safloresmo/escaner-lidar/docs/img/sensor-montado.jpg

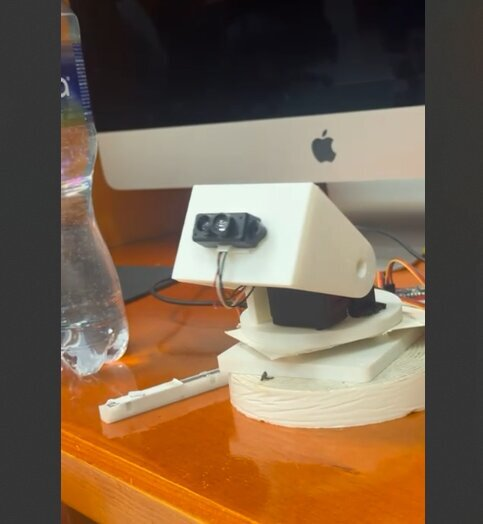
docs/img/sensor-montado.jpg
