safloresmo/escaner-lidar/fpga/restricciones/pynq-z1.xdc

# Copyright (C) 2022 Xilinx, Inc
# SPDX-License-Identifier: BSD-3-Clause

## Switches
set_property -dict {PACKAGE_PIN M20 IOSTANDARD LVCMOS33} [get_ports {sw[0]}]
set_property -dict {PACKAGE_PIN M19 IOSTANDARD LVCMOS33} [get_ports {led[1]}]

## Buttons
set_property -dict {PACKAGE_PIN D19 IOSTANDARD LVCMOS33} [get_ports {btn[0]}]
set_property -dict {PACKAGE_PIN D20 IOSTANDARD LVCMOS33} [get_ports {btn[1]}]
set_property -dict {PACKAGE_PIN L20 IOSTANDARD LVCMOS33} [get_ports {btn[2]}]
set_property -dict {PACKAGE_PIN L19 IOSTANDARD LVCMOS33} [get_ports {btn[3]}]

## LEDs
set_property -dict {PACKAGE_PIN R14 IOSTANDARD LVCMOS33} [get_ports {led[0]}]
set_property -dict {PACKAGE_PIN P14 IOSTANDARD LVCMOS33} [get_ports {led[1]}]
set_property -dict {PACKAGE_PIN N16 IOSTANDARD LVCMOS33} [get_ports {led[2]}]
set_property -dict {PACKAGE_PIN M14 IOSTANDARD LVCMOS33} [get_ports {led[3]}]

## RGBLEDs
set_property -dict { PACKAGE_PIN L15   IOSTANDARD LVCMOS33 } [get_ports led4_b]; #led 4 Blue
set_property -dict { PACKAGE_PIN G17   IOSTANDARD LVCMOS33 } [get_ports led4_g]; #led 4 Green
set_property -dict { PACKAGE_PIN N15   IOSTANDARD LVCMOS33 } [get_ports led4_r]; #led 4 Red
set_property -dict { PACKAGE_PIN G14   IOSTANDARD LVCMOS33 } [get_ports led5_b]; #led 5 Blue
set_property -dict { PACKAGE_PIN L14   IOSTANDARD LVCMOS33 } [get_ports led5_g]; #led 5 Green
set_property -dict { PACKAGE_PIN M15   IOSTANDARD LVCMOS33 } [get_ports led5_r]; #led 5 Red

## Audio
set_property -dict {PACKAGE_PIN F17 IOSTANDARD LVCMOS33} [get_ports {pdm_m_clk[0]}]
set_property -dict {PACKAGE_PIN G18 IOSTANDARD LVCMOS33} [get_ports pdm_m_data_i]
set_property -dict {PACKAGE_PIN R18 IOSTANDARD LVCMOS33} [get_ports {pwm_audio_o[0]}]
set_property -dict {PACKAGE_PIN T17 IOSTANDARD LVCMOS33} [get_ports {pdm_audio_shutdown[0]}]

# HDMI Signals
create_clock -period 8.334 -waveform {0.000 4.167} [get_ports hdmi_in_clk_p]
set_property -dict {PACKAGE_PIN P19 IOSTANDARD TMDS_33} [get_ports hdmi_in_clk_n]
set_property -dict {PACKAGE_PIN N18 IOSTANDARD TMDS_33} [get_ports hdmi_in_clk_p]
set_property -dict {PACKAGE_PIN W20 IOSTANDARD TMDS_33} [get_ports {hdmi_in_data_n[0]}]
set_property -dict {PACKAGE_PIN V20 IOSTANDARD TMDS_33} [get_ports {hdmi_in_data_p[0]}]
set_property -dict {PACKAGE_PIN U20 IOSTANDARD TMDS_33} [get_ports {hdmi_in_data_n[1]}]
set_property -dict {PACKAGE_PIN T20 IOSTANDARD TMDS_33} [get_ports {hdmi_in_data_p[1]}]
set_property -dict {PACKAGE_PIN P20 IOSTANDARD TMDS_33} [get_ports {hdmi_in_data_n[2]}]
set_property -dict {PACKAGE_PIN N20 IOSTANDARD TMDS_33} [get_ports {hdmi_in_data_p[2]}]
set_property -dict {PACKAGE_PIN T19 IOSTANDARD LVCMOS33} [get_ports {hdmi_in_hpd[0]}]
set_property -dict {PACKAGE_PIN U14 IOSTANDARD LVCMOS33} [get_ports hdmi_in_ddc_scl_io]
set_property -dict {PACKAGE_PIN U15 IOSTANDARD LVCMOS33} [get_ports hdmi_in_ddc_sda_io]
set_property -dict {PACKAGE_PIN L17 IOSTANDARD TMDS_33} [get_ports hdmi_out_clk_n]
set_property -dict {PACKAGE_PIN L16 IOSTANDARD TMDS_33} [get_ports hdmi_out_clk_p]
set_property -dict {PACKAGE_PIN K18 IOSTANDARD TMDS_33} [get_ports {hdmi_out_data_n[0]}]
set_property -dict {PACKAGE_PIN K17 IOSTANDARD TMDS_33} [get_ports {hdmi_out_data_p[0]}]
set_property -dict {PACKAGE_PIN J19 IOSTANDARD TMDS_33} [get_ports {hdmi_out_data_n[1]}]
set_property -dict {PACKAGE_PIN K19 IOSTANDARD TMDS_33} [get_ports {hdmi_out_data_p[1]}]
set_property -dict {PACKAGE_PIN H18 IOSTANDARD TMDS_33} [get_ports {hdmi_out_data_n[2]}]
set_property -dict {PACKAGE_PIN J18 IOSTANDARD TMDS_33} [get_ports {hdmi_out_data_p[2]}]
set_property -dict {PACKAGE_PIN R19 IOSTANDARD LVCMOS33} [get_ports {hdmi_out_hpd[0]}]
set_property -dict {PACKAGE_PIN M17 IOSTANDARD LVCMOS33} [get_ports hdmi_out_ddc_scl_io]
set_property -dict {PACKAGE_PIN M18 IOSTANDARD LVCMOS33} [get_ports hdmi_out_ddc_sda_io]

## Pmoda
set_property -dict {PACKAGE_PIN Y19 IOSTANDARD LVCMOS33} [get_ports {pmoda_gpio_tri_io[1]}]
set_property -dict {PACKAGE_PIN Y18 IOSTANDARD LVCMOS33} [get_ports {pmoda_gpio_tri_io[0]}]
set_property -dict {PACKAGE_PIN Y17 IOSTANDARD LVCMOS33} [get_ports {pmoda_gpio_tri_io[3]}]
set_property -dict {PACKAGE_PIN Y16 IOSTANDARD LVCMOS33} [get_ports {pmoda_gpio_tri_io[2]}]
set_property -dict {PACKAGE_PIN U19 IOSTANDARD LVCMOS33} [get_ports {pmoda_gpio_tri_io[5]}]
set_property -dict {PACKAGE_PIN U18 IOSTANDARD LVCMOS33} [get_ports {pmoda_gpio_tri_io[4]}]
set_property -dict {PACKAGE_PIN W19 IOSTANDARD LVCMOS33} [get_ports {pmoda_gpio_tri_io[7]}]
set_property -dict {PACKAGE_PIN W18 IOSTANDARD LVCMOS33} [get_ports {pmoda_gpio_tri_io[6]}]
set_property PULLUP true [get_ports {pmoda_gpio_tri_io[2]}]
set_property PULLUP true [get_ports {pmoda_gpio_tri_io[3]}]
set_property PULLUP true [get_ports {pmoda_gpio_tri_io[6]}]
set_property PULLUP true [get_ports {pmoda_gpio_tri_io[7]}]

## Pmodb
set_property -dict {PACKAGE_PIN Y14 IOSTANDARD LVCMOS33} [get_ports {pmodb_gpio_tri_io[1]}]
set_property -dict {PACKAGE_PIN W14 IOSTANDARD LVCMOS33} [get_ports {pmodb_gpio_tri_io[0]}]
set_property -dict {PACKAGE_PIN T10 IOSTANDARD LVCMOS33} [get_ports {pmodb_gpio_tri_io[3]}]
set_property -dict {PACKAGE_PIN T11 IOSTANDARD LVCMOS33} [get_ports {pmodb_gpio_tri_io[2]}]
set_property -dict {PACKAGE_PIN W16 IOSTANDARD LVCMOS33} [get_ports {pmodb_gpio_tri_io[5]}]
set_property -dict {PACKAGE_PIN V16 IOSTANDARD LVCMOS33} [get_ports {pmodb_gpio_tri_io[4]}]
set_property -dict {PACKAGE_PIN W13 IOSTANDARD LVCMOS33} [get_ports {pmodb_gpio_tri_io[7]}]
set_property -dict {PACKAGE_PIN V12 IOSTANDARD LVCMOS33} [get_ports {pmodb_gpio_tri_io[6]}]
set_property PULLUP true [get_ports {pmodb_gpio_tri_io[2]}]
set_property PULLUP true [get_ports {pmodb_gpio_tri_io[3]}]
set_property PULLUP true [get_ports {pmodb_gpio_tri_io[6]}]
set_property PULLUP true [get_ports {pmodb_gpio_tri_io[7]}]

## Arduino digital
create_clock -name clk -period 10.0 [get_ports clock]
set_property -dict {PACKAGE_PIN T14 IOSTANDARD LVCMOS33} [get_ports {pd[0]}]    
set_property -dict {PACKAGE_PIN U12 IOSTANDARD LVCMOS33} [get_ports {pd[1]}]    
set_property -dict {PACKAGE_PIN U13 IOSTANDARD LVCMOS33} [get_ports {pd[2]}]    
set_property -dict {PACKAGE_PIN V13 IOSTANDARD LVCMOS33} [get_ports {pd[3]}]    
set_property -dict {PACKAGE_PIN V15 IOSTANDARD LVCMOS33} [get_ports {pd[4]}]    
set_property -dict {PACKAGE_PIN T15 IOSTANDARD LVCMOS33} [get_ports {pd[5]}]    
set_property -dict {PACKAGE_PIN R16 IOSTANDARD LVCMOS33} [get_ports {pd[6]}]    
set_property -dict {PACKAGE_PIN U17 IOSTANDARD LVCMOS33} [get_ports {pd[7]}]    
set_property -dict {PACKAGE_PIN V17 IOSTANDARD LVCMOS33} [get_ports {pb[0]}]    
set_property -dict {PACKAGE_PIN V18 IOSTANDARD LVCMOS33} [get_ports {pb[1]}]    
set_property -dict {PACKAGE_PIN T16 IOSTANDARD LVCMOS33} [get_ports {pb[2]}]    
set_property -dict {PACKAGE_PIN R17 IOSTANDARD LVCMOS33} [get_ports {pb[3]}]    
set_property -dict {PACKAGE_PIN P18 IOSTANDARD LVCMOS33} [get_ports {pb[4]}]    
set_property -dict {PACKAGE_PIN N17 IOSTANDARD LVCMOS33} [get_ports {pb[5]}]    
set_property -dict {PACKAGE_PIN P16 IOSTANDARD LVCMOS33} [get_ports scl]    
set_property -dict {PACKAGE_PIN P15 IOSTANDARD LVCMOS33} [get_ports sda]    
set_property -dict {PACKAGE_PIN W15 IOSTANDARD LVCMOS33} [get_ports spi_miso]
set_property -dict {PACKAGE_PIN T12 IOSTANDARD LVCMOS33} [get_ports spi_mosi]
set_property -dict {PACKAGE_PIN H15 IOSTANDARD LVCMOS33} [get_ports spi_sck]
set_property -dict {PACKAGE_PIN F16 IOSTANDARD LVCMOS33} [get_ports spi_ss]
set_property -dict {PACKAGE_PIN U10 IOSTANDARD LVCMOS33} [get_ports {pc[5]}]    
set_property -dict {PACKAGE_PIN T5 IOSTANDARD LVCMOS33} [get_ports {pc[4]}]     
set_property -dict {PACKAGE_PIN V11 IOSTANDARD LVCMOS33} [get_ports {pc[3]}]    
set_property -dict {PACKAGE_PIN W11 IOSTANDARD LVCMOS33} [get_ports {pc[2]}]   
set_property -dict {PACKAGE_PIN Y12 IOSTANDARD LVCMOS33} [get_ports {pc[1]}]    
set_property -dict {PACKAGE_PIN Y11 IOSTANDARD LVCMOS33} [get_ports {pc[0]}]    

## Arduino analog
set_property -dict {PACKAGE_PIN D18 IOSTANDARD LVCMOS33} [get_ports Vaux1_v_n]
set_property -dict {PACKAGE_PIN E17 IOSTANDARD LVCMOS33} [get_ports Vaux1_v_p]
set_property -dict {PACKAGE_PIN E19 IOSTANDARD LVCMOS33} [get_ports Vaux9_v_n]
set_property -dict {PACKAGE_PIN E18 IOSTANDARD LVCMOS33} [get_ports Vaux9_v_p]
set_property -dict {PACKAGE_PIN J14 IOSTANDARD LVCMOS33} [get_ports Vaux6_v_n]
set_property -dict {PACKAGE_PIN K14 IOSTANDARD LVCMOS33} [get_ports Vaux6_v_p]
set_property -dict {PACKAGE_PIN J16 IOSTANDARD LVCMOS33} [get_ports Vaux15_v_n]
set_property -dict {PACKAGE_PIN K16 IOSTANDARD LVCMOS33} [get_ports Vaux15_v_p]
set_property -dict {PACKAGE_PIN H20 IOSTANDARD LVCMOS33} [get_ports Vaux5_v_n]
set_property -dict {PACKAGE_PIN J20 IOSTANDARD LVCMOS33} [get_ports Vaux5_v_p]
set_property -dict {PACKAGE_PIN G20 IOSTANDARD LVCMOS33} [get_ports Vaux13_v_n]
set_property -dict {PACKAGE_PIN G19 IOSTANDARD LVCMOS33} [get_ports Vaux13_v_p]

## ChipKit digital
set_property -dict { PACKAGE_PIN U5    IOSTANDARD LVCMOS33 } [get_ports {ck_gpio_tri_io[0]}];
set_property -dict { PACKAGE_PIN V5    IOSTANDARD LVCMOS33 } [get_ports {ck_gpio_tri_io[1]}];
set_property -dict { PACKAGE_PIN V6    IOSTANDARD LVCMOS33 } [get_ports {ck_gpio_tri_io[2]}];
set_property -dict { PACKAGE_PIN U7    IOSTANDARD LVCMOS33 } [get_ports {ck_gpio_tri_io[3]}];
set_property -dict { PACKAGE_PIN V7    IOSTANDARD LVCMOS33 } [get_ports {ck_gpio_tri_io[4]}];
set_property -dict { PACKAGE_PIN U8    IOSTANDARD LVCMOS33 } [get_ports {ck_gpio_tri_io[5]}];
set_property -dict { PACKAGE_PIN V8    IOSTANDARD LVCMOS33 } [get_ports {ck_gpio_tri_io[6]}];
set_property -dict { PACKAGE_PIN V10   IOSTANDARD LVCMOS33 } [get_ports {ck_gpio_tri_io[7]}];
set_property -dict { PACKAGE_PIN W10   IOSTANDARD LVCMOS33 } [get_ports {ck_gpio_tri_io[8]}];
set_property -dict { PACKAGE_PIN W6    IOSTANDARD LVCMOS33 } [get_ports {ck_gpio_tri_io[9]}];
set_property -dict { PACKAGE_PIN Y6    IOSTANDARD LVCMOS33 } [get_ports {ck_gpio_tri_io[10]}];
set_property -dict { PACKAGE_PIN Y7    IOSTANDARD LVCMOS33 } [get_ports {ck_gpio_tri_io[11]}];
set_property -dict { PACKAGE_PIN W8    IOSTANDARD LVCMOS33 } [get_ports {ck_gpio_tri_io[12]}];
set_property -dict { PACKAGE_PIN Y8    IOSTANDARD LVCMOS33 } [get_ports {ck_gpio_tri_io[13]}];
set_property -dict { PACKAGE_PIN W9    IOSTANDARD LVCMOS33 } [get_ports {ck_gpio_tri_io[14]}];
set_property -dict { PACKAGE_PIN Y9    IOSTANDARD LVCMOS33 } [get_ports {ck_gpio_tri_io[15]}];

## ChipKit analog
set_property -dict { PACKAGE_PIN F19   IOSTANDARD LVCMOS33 } [get_ports Vaux12_v_p];
set_property -dict { PACKAGE_PIN F20   IOSTANDARD LVCMOS33 } [get_ports Vaux12_v_n];
set_property -dict { PACKAGE_PIN C20   IOSTANDARD LVCMOS33 } [get_ports Vaux0_v_p];
set_property -dict { PACKAGE_PIN B20   IOSTANDARD LVCMOS33 } [get_ports Vaux0_v_n];
set_property -dict { PACKAGE_PIN B19   IOSTANDARD LVCMOS33 } [get_ports Vaux8_v_p];
set_property -dict { PACKAGE_PIN A20   IOSTANDARD LVCMOS33 } [get_ports Vaux8_v_n];

# Asigna un IOSTANDARD para los puertos no especificados
set_property IOSTANDARD LVCMOS33 [get_ports {clk}]
set_property IOSTANDARD LVCMOS33 [get_ports {reset}]
set_property IOSTANDARD LVCMOS33 [get_ports {data_valid}]
set_property IOSTANDARD LVCMOS33 [get_ports {distance[*]}]

# Opcional: Degrada la severidad de los chequeos para permitir la generación del bitstream
set_property SEVERITY {Warning} [get_drc_checks NSTD-1]
set_property SEVERITY {Warning} [get_drc_checks UCIO-1]
