safloresmo/escaner-lidar/fpga/restricciones/uart_pmodb.xdc

# UART por PMOD B
set_property PACKAGE_PIN W14 [get_ports uart_rtl_0_rxd]
set_property IOSTANDARD LVCMOS33 [get_ports uart_rtl_0_rxd]

set_property PACKAGE_PIN Y14 [get_ports uart_rtl_0_txd]
set_property IOSTANDARD LVCMOS33 [get_ports uart_rtl_0_txd]
